kgiorgi/TinyDyno/docs/images/block-diagram.drawio(1).png

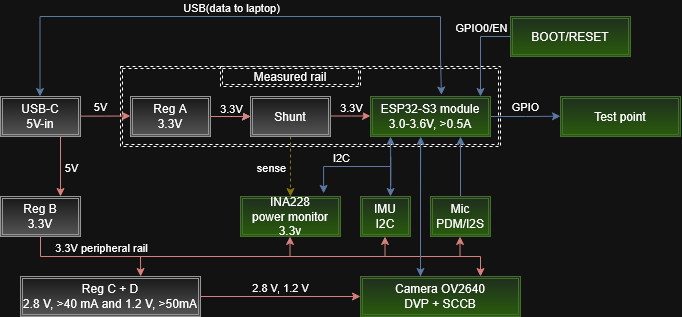
docs/images/block-diagram.drawio(1).png
