kgiorgi/TinyDyno/docs/images/Screenshot 2026-10-16 222043.png

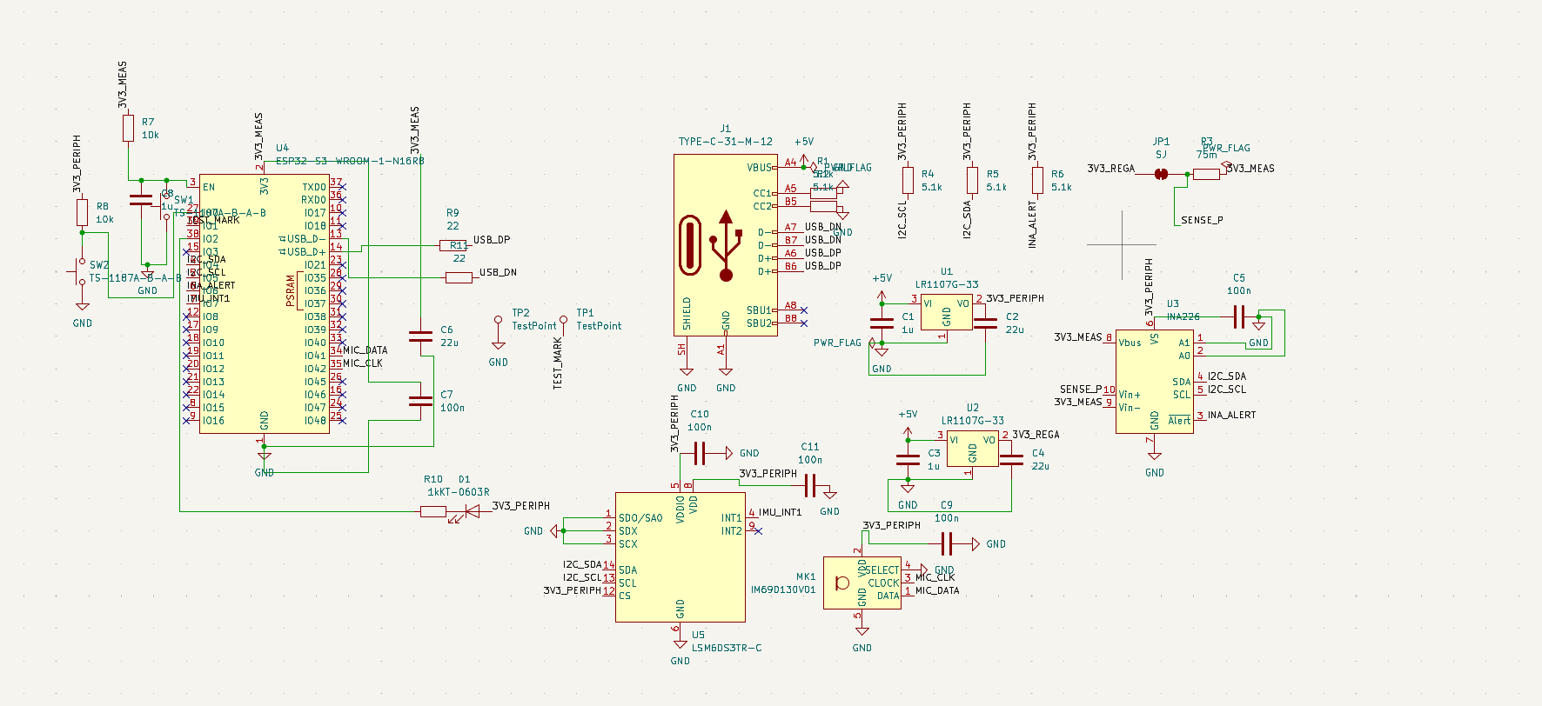
docs/images/Screenshot 2026-10-16 222043.png
