kgiorgi/TinyDyno/docs/images/Screenshot 2026-10-16 222128.png

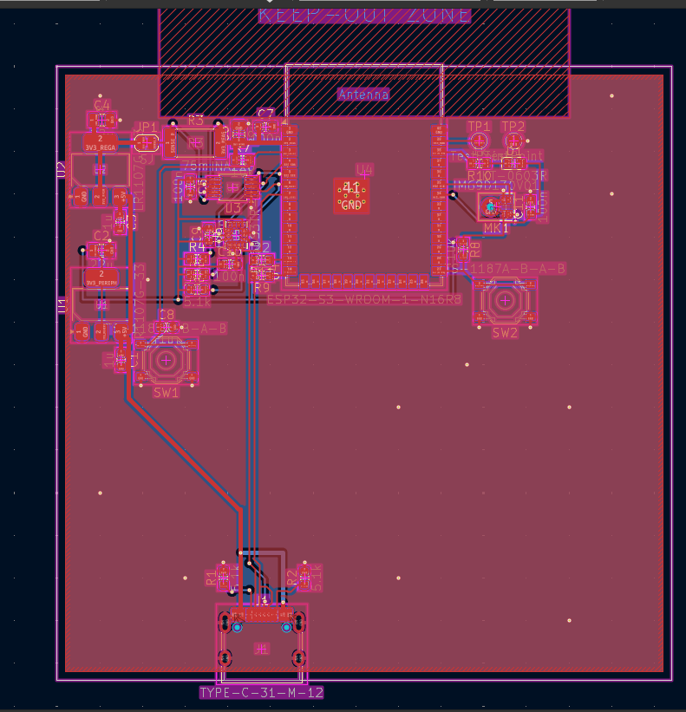
docs/images/Screenshot 2026-10-16 222128.png
