kgiorgi/TinyDyno/BOM.csv

Item | Qty | Supplier | Cost/item | Total Cost | link
TinyDyno PCB, 2-layer, 72 × 72 mm (×5 boards) | 1 | JLCPCB | $4.00 | $4.00 | https://jlcpcb.com
ESP32-S3-WROOM-1-N16R8 (×2) | 1 | LCSC | $10.29 | $10.29 | https://lcsc.com/product-detail/C2913202.html
IM69D130V01 PDM microphone (×2) | 1 | LCSC | $6.25 | $6.25 | https://lcsc.com/product-detail/C536262.html
LSM6DS3TR-C IMU (×2) | 1 | LCSC | $3.04 | $3.04 | https://lcsc.com/product-detail/C967633.html
INA226AIDGSR (×2) | 1 | LCSC | $1.52 | $1.52 | https://lcsc.com/product-detail/C49851.html
LR1107G-33 regulator (×5) | 1 | LCSC | $0.86 | $0.86 | https://lcsc.com/product-detail/C171499.html
75 mΩ 2512 shunt resistor (×5) | 1 | LCSC | $0.58 | $0.58 | https://lcsc.com/product-detail/C76252.html
USB-C TYPE-C-31-M-12 (×2) | 1 | LCSC | $0.37 | $0.37 | https://lcsc.com/product-detail/C165948.html
Standard PCB assembly, 2 boards, top side | 1 | JLCPCB | $66.86 | $66.86 | https://jlcpcb.com
5.1k resistor 0603, R1 R2 R4 R5 R6 (x20) | 1 | LCSC | $0.03 | $0.03 | https://lcsc.com/product-detail/C23186.html
10k resistor 0603, R7 R8 (x20) | 1 | LCSC | $0.04 | $0.04 | https://lcsc.com/product-detail/C25804.html
22 Ohm resistor 0603, R9 R11 (x20) | 1 | LCSC | $0.03 | $0.03 | https://lcsc.com/product-detail/C23345.html
1k resistor 0603, R10 (x20) | 1 | LCSC | $0.05 | $0.05 | https://lcsc.com/product-detail/C21190.html
100nF capacitor 0603, C5 C7 C9 C10 C11 (x20) | 1 | LCSC | $0.28 | $0.28 | https://lcsc.com/product-detail/C14663.html
1uF capacitor 0603, C1 C3 C8 (x20) | 1 | LCSC | $0.33 | $0.33 | https://lcsc.com/product-detail/C15849.html
22uF capacitor 0805, C2 C4 C6 (x6) | 1 | LCSC | $1.32 | $1.32 | https://lcsc.com/product-detail/C45783.html
Red LED 0603, D1 (x20) | 1 | LCSC | $0.15 | $0.15 | https://lcsc.com/product-detail/C2286.html
Push button TS-1187A, SW1 SW2 (x9) | 1 | LCSC | $0.19 | $0.19 | https://lcsc.com/product-detail/C318884.html
Estimated total shipping | 1 |  |  | $0.00
