kgiorgi/TinyDyno/hardware/kicad/TinyDyno.kicad_pcb

## KiCad design hardware/kicad/TinyDyno.kicad_pcb (2026-10-11)

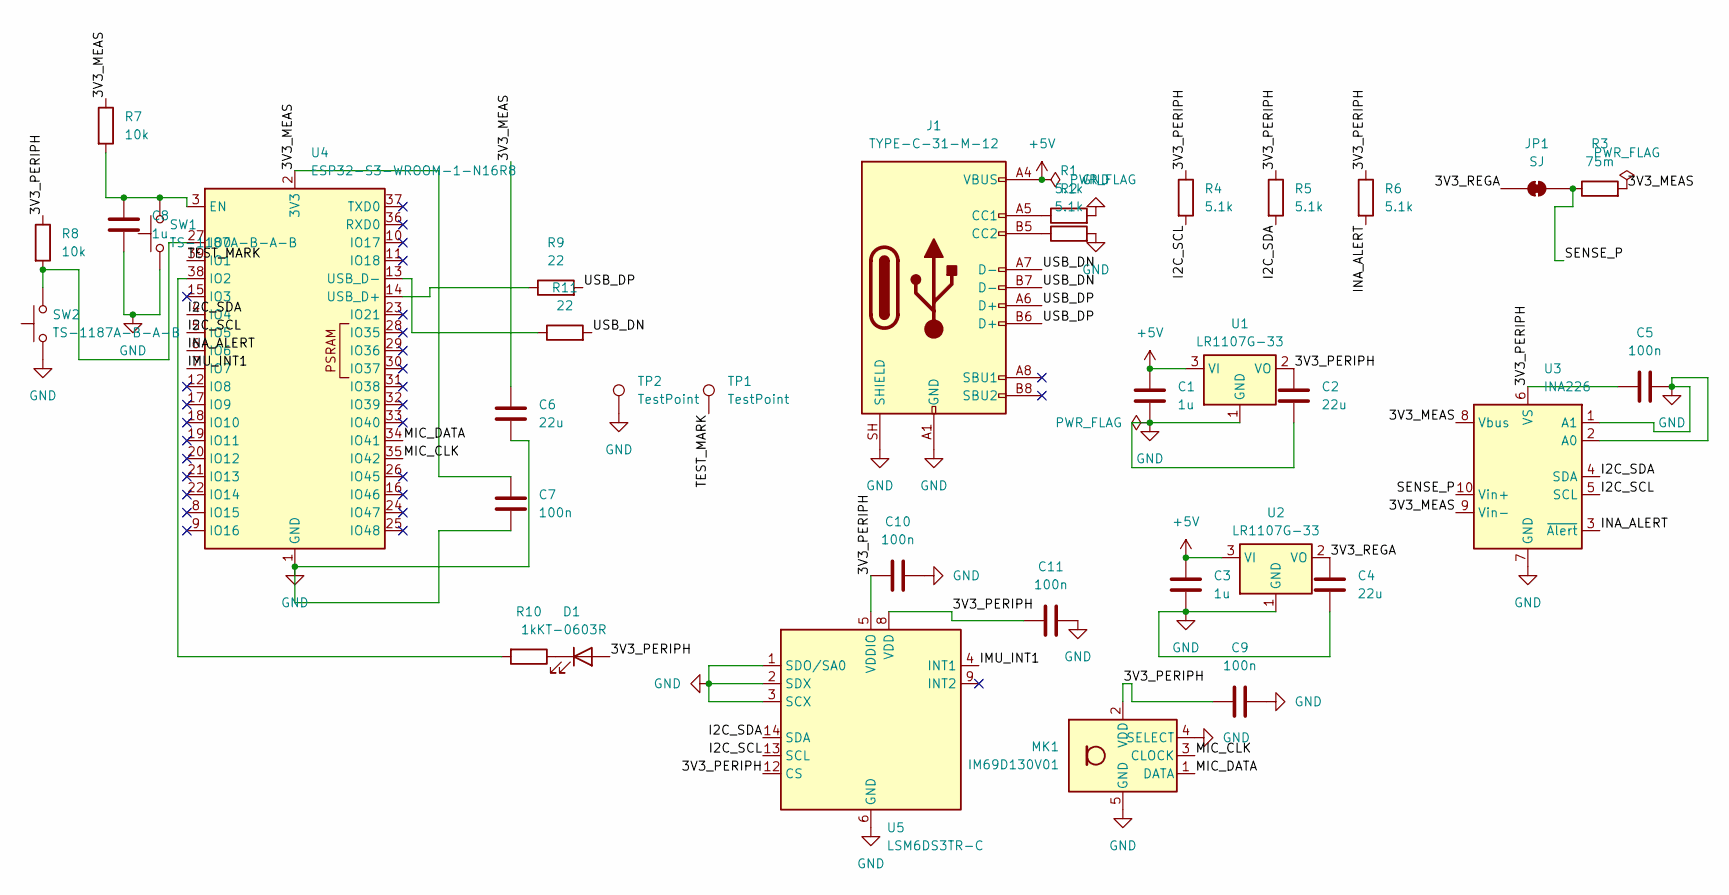
[picture p6: schematic TinyDyno.kicad_sch]

Parts:
C1, C3, C8: 1u; C_0603_1608Metric; LCSC C15849
C2, C4, C6: 22u; C_0805_2012Metric; LCSC C45783
C5, C7, C9, C10, C11: 100n; C_0603_1608Metric; LCSC C14663
D1: KT-0603R; LED_0603_1608Metric; LCSC C2286
J1: TYPE-C-31-M-12; USB_C_Receptacle_HRO_TYPE-C-31-M-12; LCSC C165948
JP1: SJ; SolderJumper-2_P1.3mm_Bridged_RoundedPad1.0x1.5mm
MK1: IM69D130V01; Infineon_PG-LLGA-5-1; LCSC C536262
R1, R2, R4, R5, R6: 5.1k; R_0603_1608Metric; LCSC C23186
R3: 75m; R_2512_6332Metric; LCSC C76252
R7, R8: 10k; R_0603_1608Metric; LCSC C25804
R9, R11: 22; R_0603_1608Metric; LCSC C23345
R10: 1k; R_0603_1608Metric; LCSC C21190
SW1, SW2: TS-1187A-B-A-B; SW_Push_1P1T_XKB_TS-1187A; LCSC C318884
TP1, TP2: TestPoint; TestPoint_Pad_D1.5mm
U1, U2: LR1107G-33; SOT-223-3_TabPin2; LCSC C171499
U3: INA226; TSSOP-10_3x3mm_P0.5mm; LCSC C49851
U4: ESP32-S3-WROOM-1-N16R8; ESP32-S3-WROOM-1; LCSC C2913202
U5: LSM6DS3TR-C; LGA-14_3x2.5mm_P0.5mm_LayoutBorder3x4y; LCSC C967633

Connections:
+5V: C1.1, C3.1, J1.A4 (VBUS), J1.A9 (VBUS), J1.B4 (VBUS), J1.B9 (VBUS), U1.3 (VI), U2.3 (VI)
/3V3_MEAS: C6.1, C7.1, R3.2, R7.1, U3.8 (Vbus), U3.9 (Vin-), U4.2 (3V3)
/3V3_PERIPH: C2.1, C5.1, C9.1, C10.1, C11.1, D1.2 (A), MK1.2 (VDD), R4.1, R5.1, R6.1, R8.1, U1.2 (VO), U3.6 (VS), U5.5 (VDDIO), U5.8 (VDD), U5.12 (CS)
/3V3_REGA: C4.1, JP1.1 (A), U2.2 (VO)
/I2C_SCL: R4.2, U3.5 (SCL), U4.5 (IO5), U5.13 (SCL)
/I2C_SDA: R5.2, U3.4 (SDA), U4.4 (IO4), U5.14 (SDA)
/IMU_INT1: U4.7 (IO7), U5.4 (INT1)
/INA_ALERT: R6.2, U3.3 (~Alert), U4.6 (IO6)
/MIC_CLK: MK1.3 (CLOCK), U4.35 (IO42)
/MIC_DATA: MK1.1 (DATA), U4.34 (IO41)
/SENSE_P: JP1.2 (B), R3.1, U3.10 (Vin+)
/TEST_MARK: TP1.1 (1_1), U4.39 (IO1)
/USB_DN: J1.A7 (D-), J1.B7 (D-), R11.2
/USB_DP: J1.A6 (D+), J1.B6 (D+), R9.2
GND: C1.2, C2.2, C3.2, C4.2, C5.2, C6.2, C7.2, C8.2, C9.2, C10.2, C11.2, J1.A1 (GND), J1.A12 (GND), J1.B1 (GND), J1.B12 (GND), J1.SH (SHIELD), MK1.4 (SELECT), MK1.5 (GND), R1.2, R2.2, SW1.1, SW2.1, TP2.1 (1_1), U1.1 (GND), U2.1 (GND), U3.1 (A1), U3.2 (A0), U3.7 (GND), U4.1 (GND), U4.40 (GND), U4.41 (GND), U5.1 (SDO/SA0), U5.2 (SDX), U5.3 (SCX), U5.6 (GND), U5.7 (GND)
unnamed: D1.1 (K), R10.1
unnamed: J1.A5 (CC1), R1.1
unnamed: J1.B5 (CC2), R2.1
unnamed: C8.1, R7.2, SW1.2, U4.3 (EN)
unnamed: R8.2, SW2.2, U4.27 (IO0)
unnamed: R10.2, U4.38 (IO2)
unnamed: R9.1, U4.14 (USB_D+)
unnamed: R11.1, U4.13 (USB_D-)

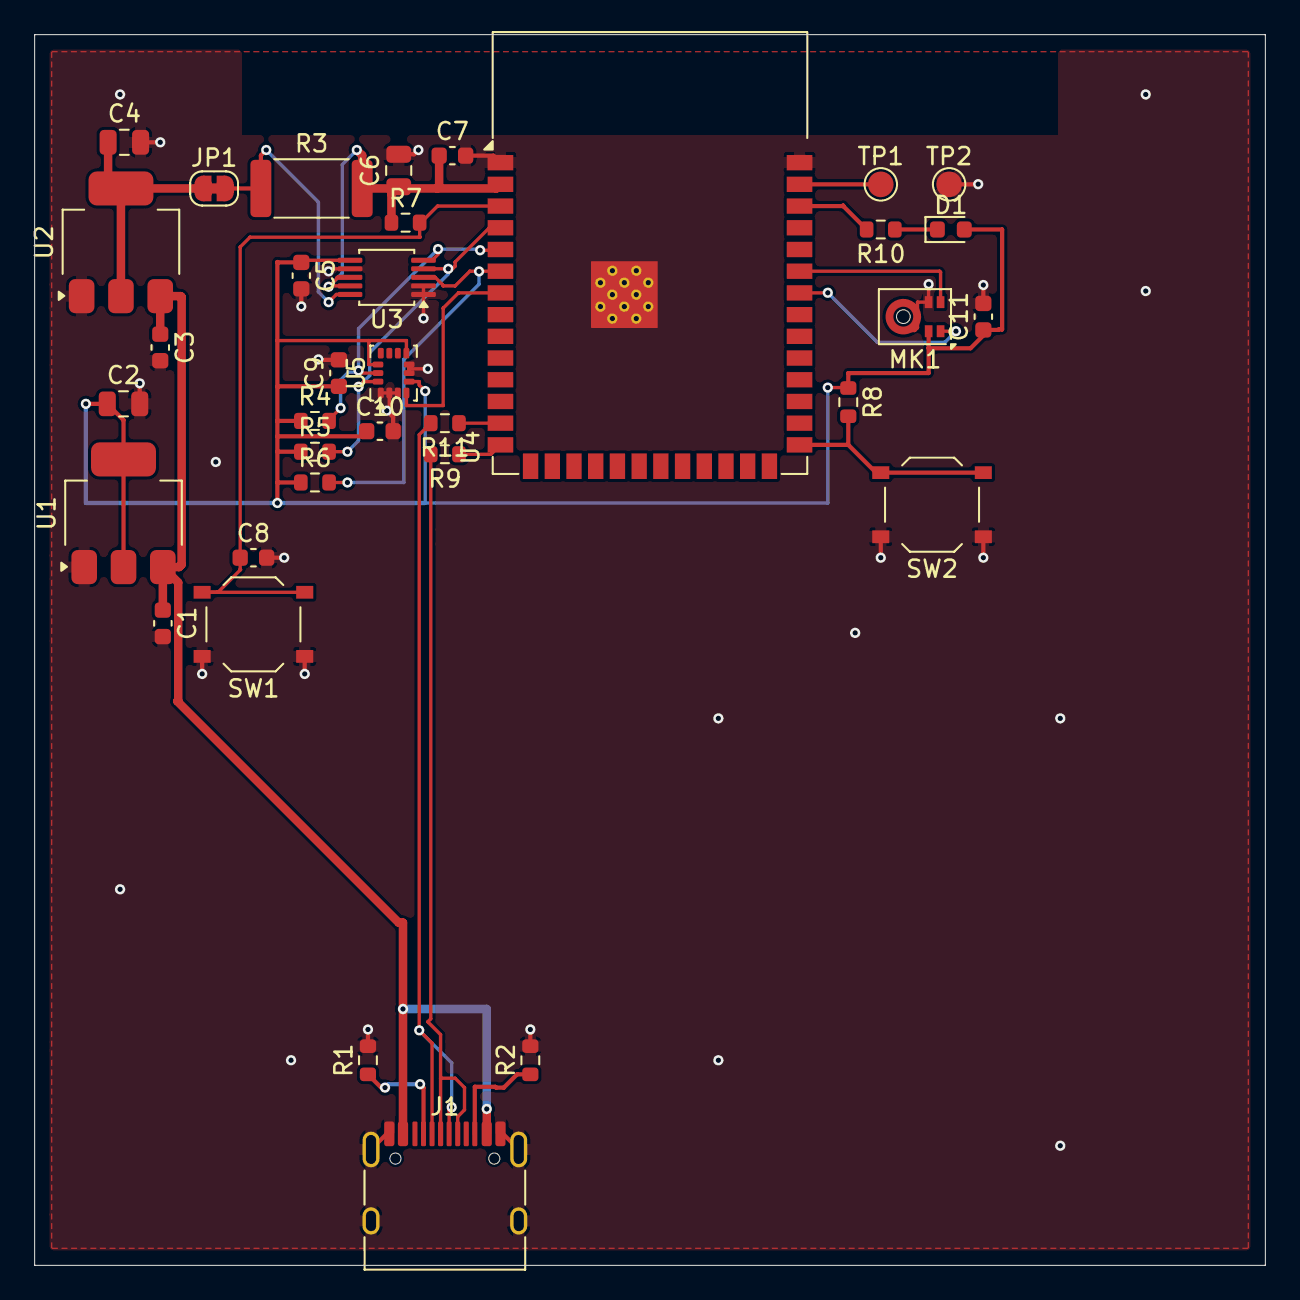
[picture p7: board TinyDyno.kicad_pcb from above]

Board: 2 copper layers, 72.0 x 72.0 mm, 35 parts (0 on the bottom side), 23 nets.
