kgiorgi/TinyDyno/(commit log)

2026-10-05 created kicad project
    [TinyDyno.kicad_pcb, TinyDyno.kicad_sch]
2026-10-05 moved to kicad10
2026-10-10 half baked schematic
    [TinyDyno.kicad_sch]
2026-10-10 Schematic done
    Finished the schematic
    [TinyDyno.kicad_sch]
2026-10-11 fixed footprints
    fixed the footprints of capacitors
2026-10-11 updated the schematic
    schematic without the camera
2026-10-11 fixed bom
    deleted test points from bom
2026-10-11 finished pcb
2026-10-11 image of the board
2026-10-16 Rename Screenshot 2026-10-16 222043.png to schematic.png
2026-10-16 Rename Screenshot 2026-10-16 222128.png to PCB.png
2026-10-23 Add board test firmware
